kbs3056/STM8L151G6U6/README.md

# STM8L151G6U6
STM8L151GxUx development board.

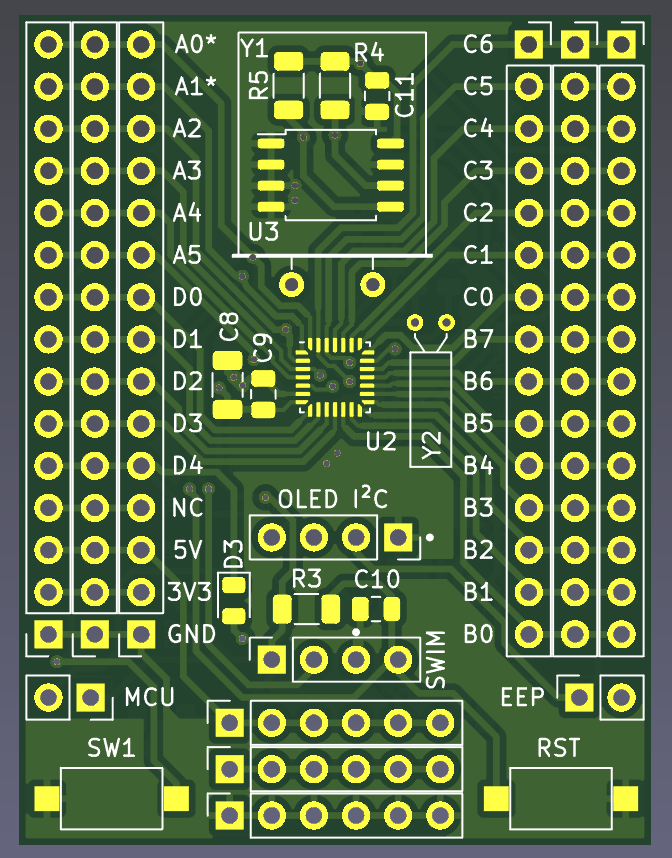
[picture p1: stm8l151.png]

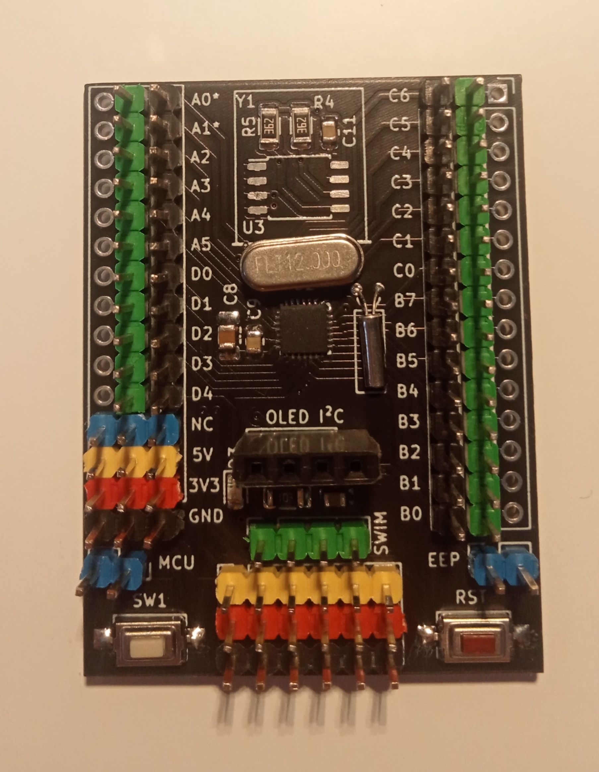
[picture p2: pcb1.jpg]

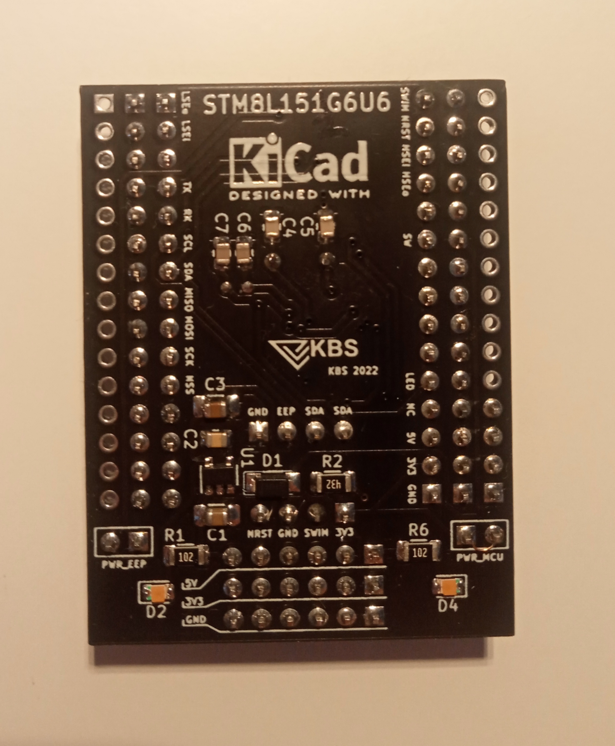
[picture p3: pcb2.jpg]
