kbs3056/STM8L151G6U6/sch.pdf

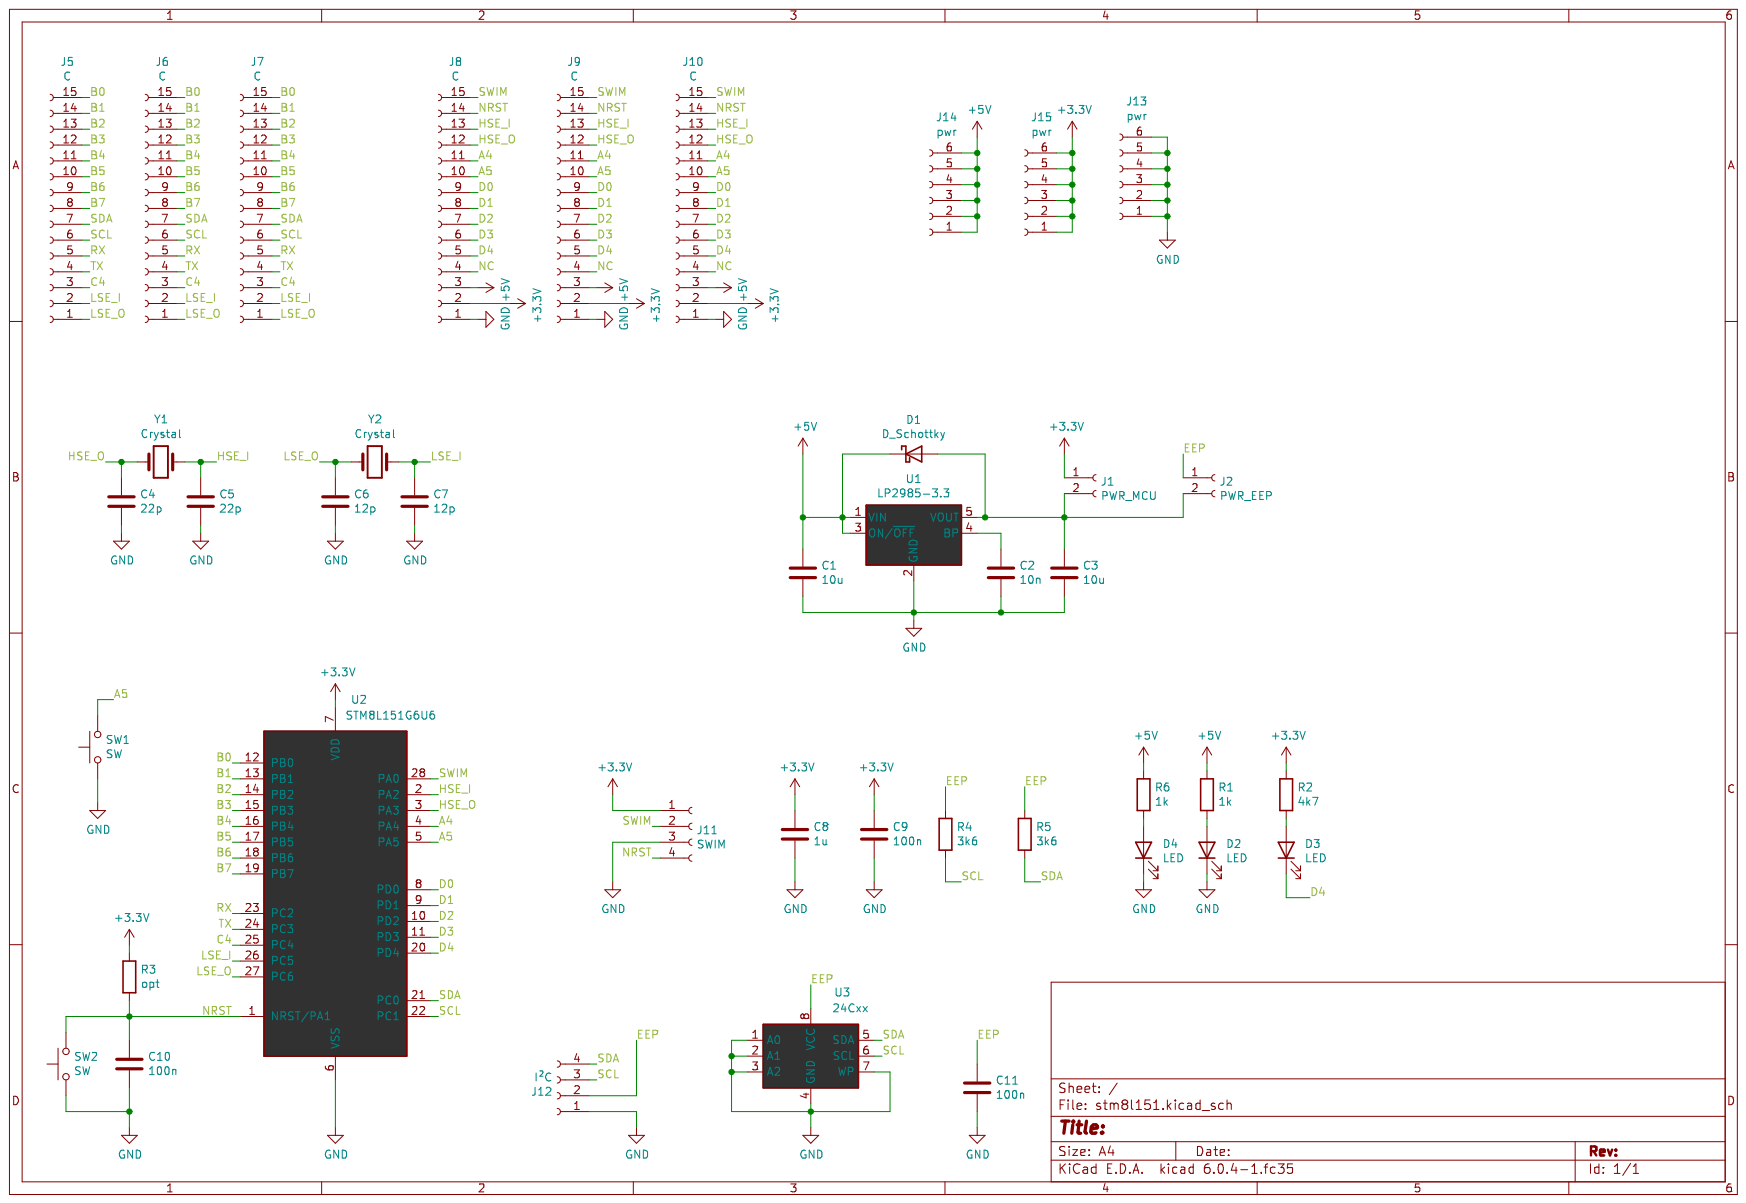
[picture p4: page 1]
