kbs3056/STM8L151G6U6/stm8l151.kicad_pcb

## KiCad design stm8l151.kicad_pcb (2022-06-09)

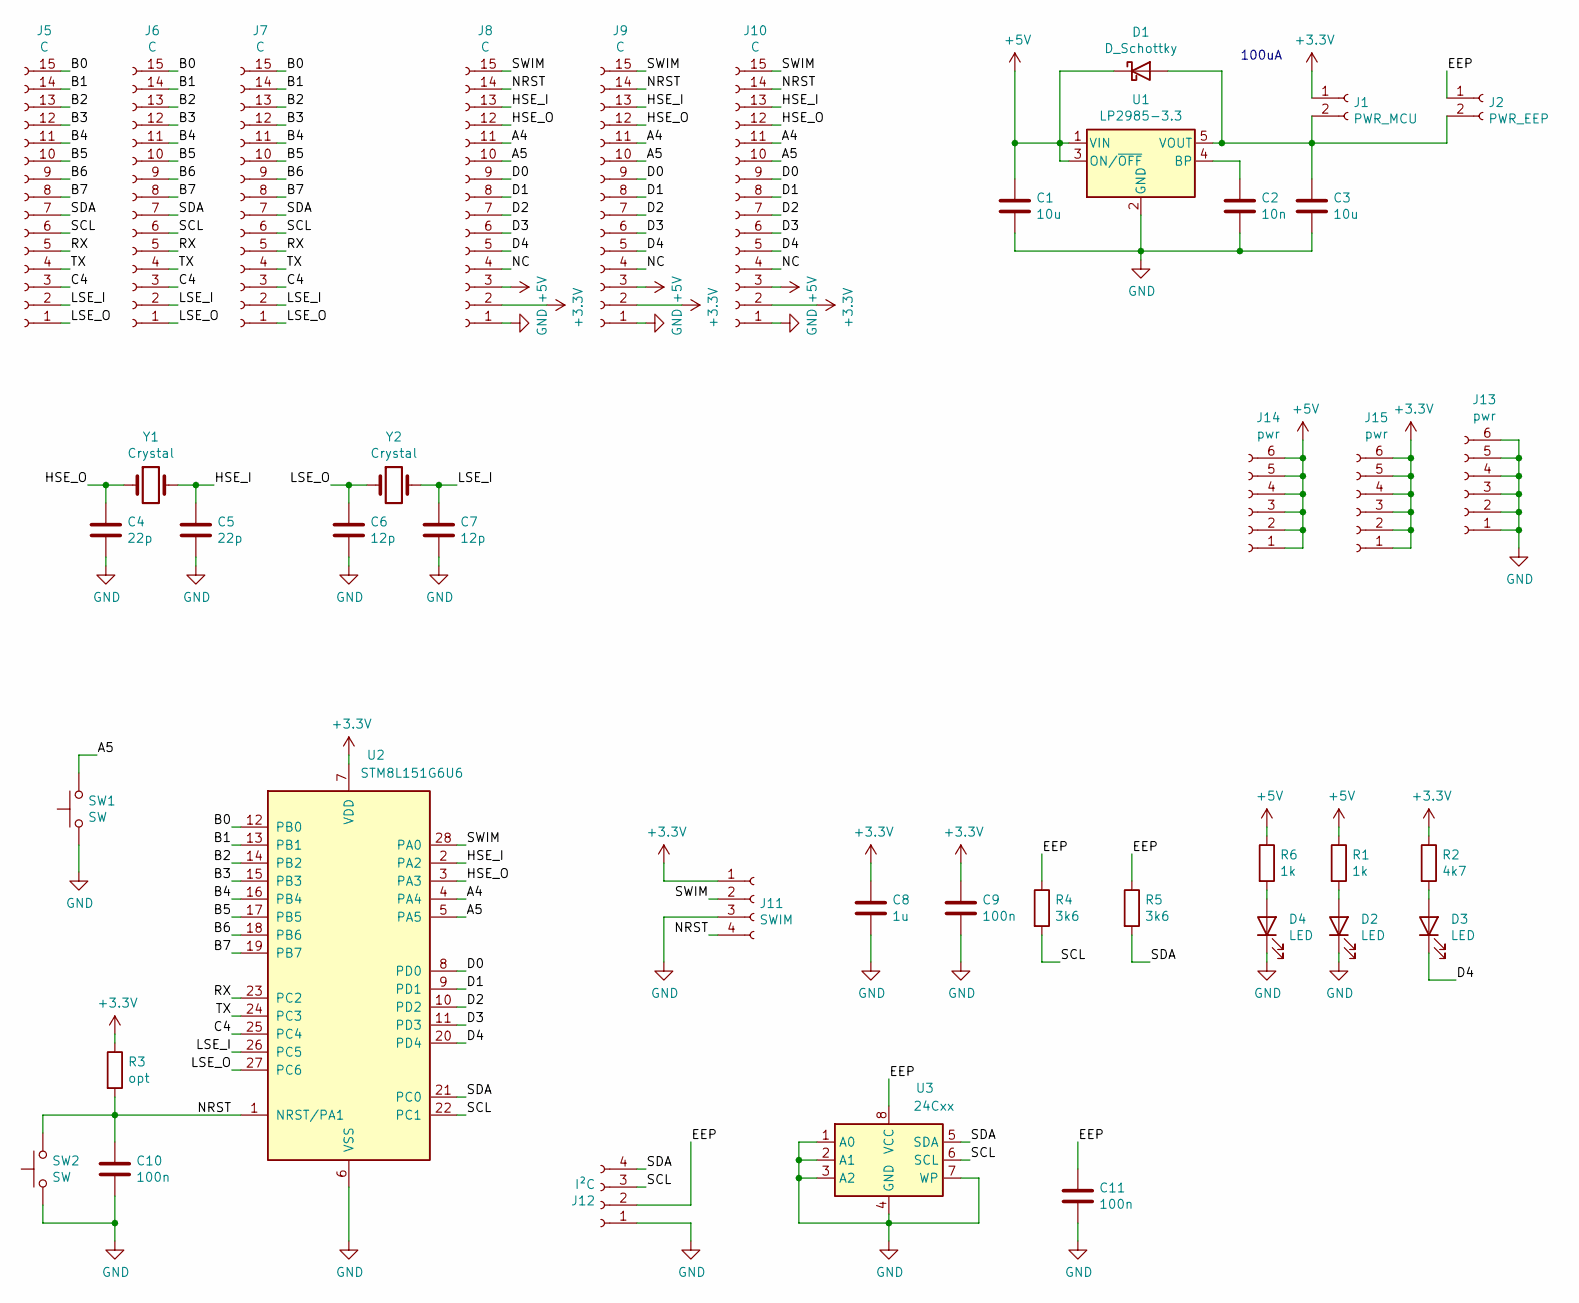
[picture p5: schematic stm8l151.kicad_sch]

Parts:
C1, C3: 10u; C_1206_3216Metric
C2: 10n; C_0805_2012Metric
C4, C5: 22p; C_0805_2012Metric
C6, C7: 12p; C_0805_2012Metric
C8: 1u; C_1206_3216Metric
C9, C10, C11: 100n; C_0805_2012Metric
D1: D_Schottky; D_MiniMELF
D2, D3, D4: LED; LED_0805_2012Metric
J1: PWR_MCU; PinSocket_1x02_P2.54mm_Vertical
J2: PWR_EEP; PinSocket_1x02_P2.54mm_Vertical
J5, J6, J7, J8, J9, J10: C; PinSocket_1x15_P2.54mm_Vertical
J11: SWIM; PinSocket_1x04_P2.54mm_Vertical
J12: I²C; PinSocket_1x04_P2.54mm_Vertical
J13, J14, J15: pwr; PinSocket_1x06_P2.54mm_Vertical
R1, R6: 1k; R_1206_3216Metric
R2: 4k7; R_1206_3216Metric
R3: opt; R_1206_3216Metric
R4, R5: 3k6; R_1206_3216Metric
SW1, SW2: SW; SW_SPST_CK_RS282G05A3
U1: LP2985-3.3; SOT-23-5
U2: STM8L151G6U6; QFN-28_4x4mm_P0.5mm
U3: 24Cxx; SOIC-8_5.23x5.23mm_P1.27mm
Y1: Crystal; Crystal_HC49-U_Horizontal
Y2: Crystal; Crystal_C26-LF_D2.1mm_L6.5mm_Horizontal

Connections:
+3V3: C8.1, C9.1, J1.1, J8.2, J9.2, J10.2, J11.1, J15.1, J15.2, J15.3, J15.4, J15.5, J15.6, R2.1, R3.1, U2.7 (VDD)
+5V: C1.1, D1.1 (K), J8.3, J9.3, J10.3, J14.1, J14.2, J14.3, J14.4, J14.5, J14.6, R1.1, R6.1, U1.1 (VIN), U1.3 (ON/~OFF)
/A4: J8.11, J9.11, J10.11, U2.4 (PA4)
/A5: J8.10, J9.10, J10.10, SW1.2, U2.5 (PA5)
/B0: J5.15, J6.15, J7.15, U2.12 (PB0)
/B1: J5.14, J6.14, J7.14, U2.13 (PB1)
/B2: J5.13, J6.13, J7.13, U2.14 (PB2)
/B3: J5.12, J6.12, J7.12, U2.15 (PB3)
/B4: J5.11, J6.11, J7.11, U2.16 (PB4)
/B5: J5.10, J6.10, J7.10, U2.17 (PB5)
/B6: J5.9, J6.9, J7.9, U2.18 (PB6)
/B7: J5.8, J6.8, J7.8, U2.19 (PB7)
/C4: J5.3, J6.3, J7.3, U2.25 (PC4)
/D0: J8.9, J9.9, J10.9, U2.8 (PD0)
/D1: J8.8, J9.8, J10.8, U2.9 (PD1)
/D2: J8.7, J9.7, J10.7, U2.10 (PD2)
/D3: J8.6, J9.6, J10.6, U2.11 (PD3)
/D4: D3.1 (K), J8.5, J9.5, J10.5, U2.20 (PD4)
/EEP: C11.1, J2.1, J12.2, R4.1, R5.1, U3.8 (VCC)
/HSE_I: C5.1, J8.13, J9.13, J10.13, U2.2 (PA2), Y1.2
/HSE_O: C4.1, J8.12, J9.12, J10.12, U2.3 (PA3), Y1.1
/LSE_I: C7.1, J5.2, J6.2, J7.2, U2.26 (PC5), Y2.2
/LSE_O: C6.1, J5.1, J6.1, J7.1, U2.27 (PC6), Y2.1
/NC: J8.4, J9.4, J10.4
/NRST: C10.1, J8.14, J9.14, J10.14, J11.4, R3.2, SW2.2, U2.1 (NRST/PA1)
/RX: J5.5, J6.5, J7.5, U2.23 (PC2)
/SCL: J5.6, J6.6, J7.6, J12.3, R4.2, U2.22 (PC1), U3.6 (SCL)
/SDA: J5.7, J6.7, J7.7, J12.4, R5.2, U2.21 (PC0), U3.5 (SDA)
/SWIM: J8.15, J9.15, J10.15, J11.2, U2.28 (PA0)
/TX: J5.4, J6.4, J7.4, U2.24 (PC3)
GND: C1.2, C2.2, C3.2, C4.2, C5.2, C6.2, C7.2, C8.2, C9.2, C10.2, C11.2, D2.1 (K), D4.1 (K), J8.1, J9.1, J10.1, J11.3, J12.1, J13.1, J13.2, J13.3, J13.4, J13.5, J13.6, SW1.1, SW2.1, U1.2 (GND), U2.6 (VSS), U3.1 (A0), U3.2 (A1), U3.3 (A2), U3.4 (GND), U3.7 (WP)
unnamed: C2.1, U1.4 (BP)
unnamed: C3.1, D1.2 (A), J1.2, J2.2, U1.5 (VOUT)
unnamed: D2.2 (A), R1.2
unnamed: D3.2 (A), R2.2
unnamed: D4.2 (A), R6.2

Notes on the sheet:
100uA

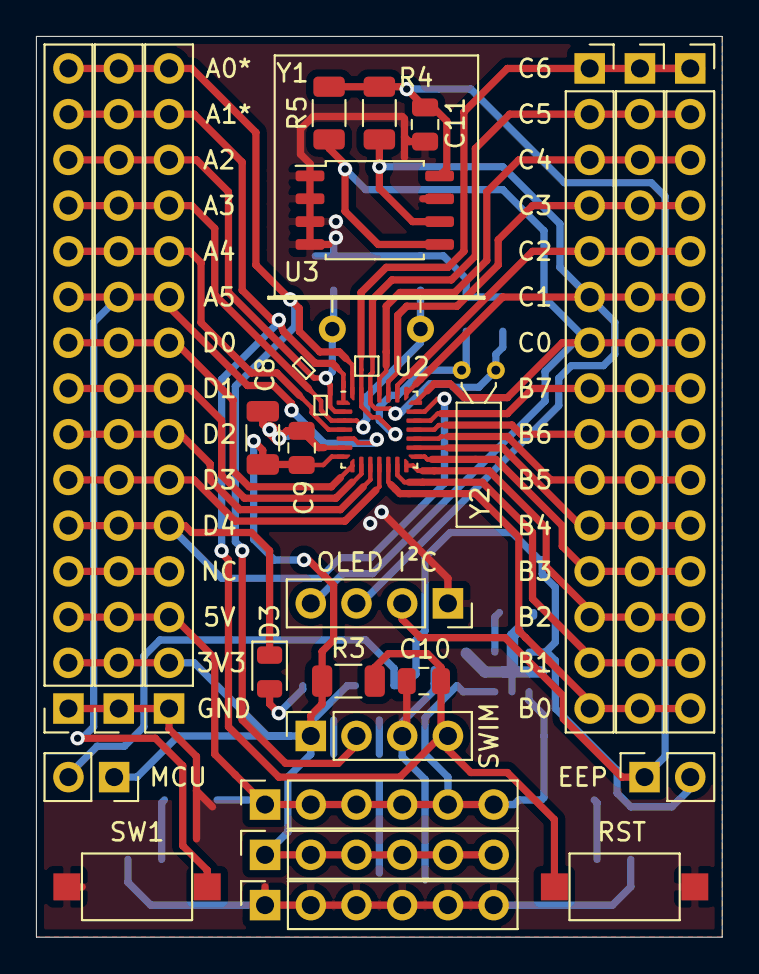
[picture p6: board stm8l151.kicad_pcb from above]

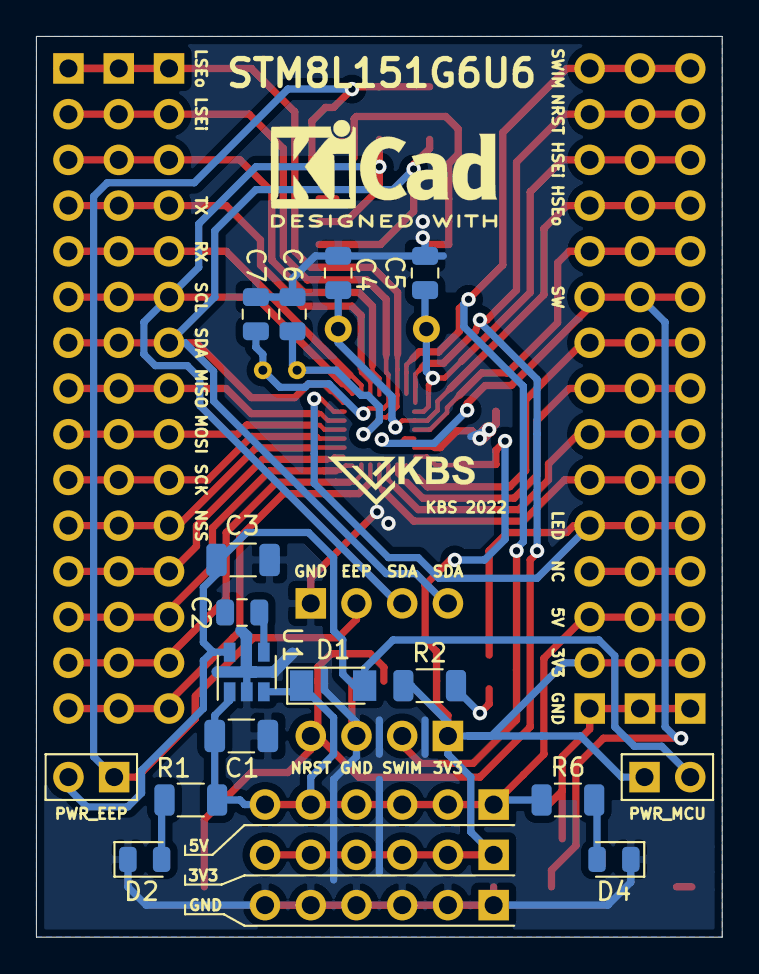
[picture p7: board stm8l151.kicad_pcb from below]

Board: 2 copper layers, 38.1 x 50.0 mm, 41 parts (14 on the bottom side), 36 nets.
